bmahabirbu/BeeSense/(commit log)

2021-11-14 Add files via upload
    Code for testing all sensors plus transmission SD and microphone don't work
2021-11-14 Update Setup.ino
    added led
2021-11-14 Update Functions.ino
    Added led blink on message sent
2021-11-16 Add files via upload
    new pi receiver added shutdown button
2021-11-16 Update Functions.ino
    added print of message to be sent
2021-11-16 replaced pct2075 with AHT20
    [SD_card_test.ino]
2022-01-25 added new comments to switch code for sd card and mic
2022-01-26 Testing SD card and Lora working together by switching cs pin
2022-02-25 reworked code tested weight transmitter
    [Weight_sensor.ino, Weight_transmitter.ino, _00_transmitter_all_sensors.ino, receiver.py]
2022-02-25 changed message sent times for prototype
2022-02-26 tested weightscale works edited code for prototype2
2022-03-04 tested code works added fake code incase of something not working
    [Sim_weight_lora.ino]
2022-03-20 added mic volts value
2022-04-27 fixed cell update order
    [receiver.py]
